BenzeneBots/Swerve_Drive/README.md

# Swerve_Drive
Swerve Drive Design

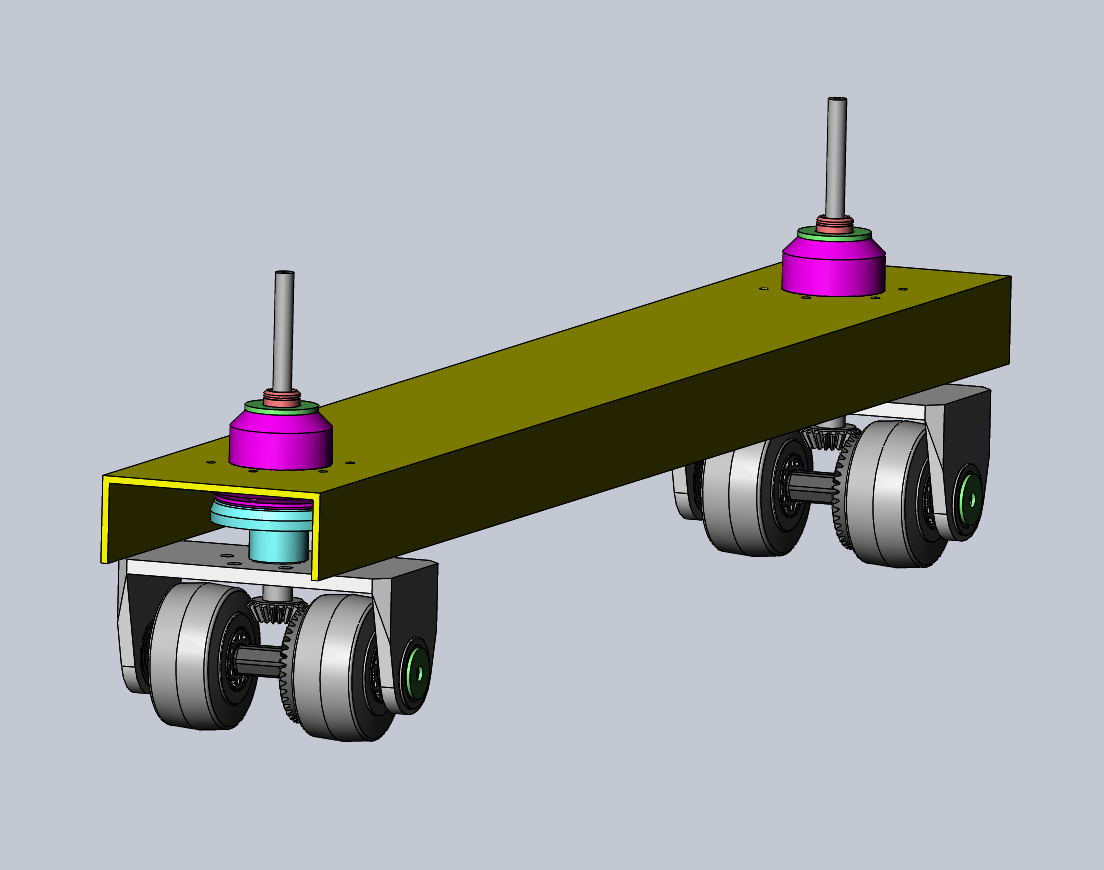
[picture p1: Docs/BB_Swerve_Frame.png]
