BenzeneBots/Swerve_Drive/FRC_2767/thirdcoast-master/README.md

Stryke Force team 2767's Third Coast swerve drive, talon configuration and telemetry API for FRC robots.



Information on these topics are available on the [Third Coast web page][site].

- Third Coast [Javadocs][javadoc].

- Third Coast [Swerve Drive][swerve].

- [Talon Configuration API][talon].

- [Telemetry API][telemetry] data streaming service for robot sensors, actuators or subsystems.

[site]: https://strykeforce.github.io/tags/thirdcoast/
[javadoc]: https://strykeforce.github.io/thirdcoast/javadoc/
[swerve]: https://strykeforce.github.io/tags/swerve/
[talon]: https://strykeforce.github.io/tags/talon/
[telemetry]: https://strykeforce.github.io/tags/telemetry/
