BenzeneBots/Swerve_Drive/FRC_2767/frc-2767-styke-force-2017-1.snapshot.6/2017 hang.jpg

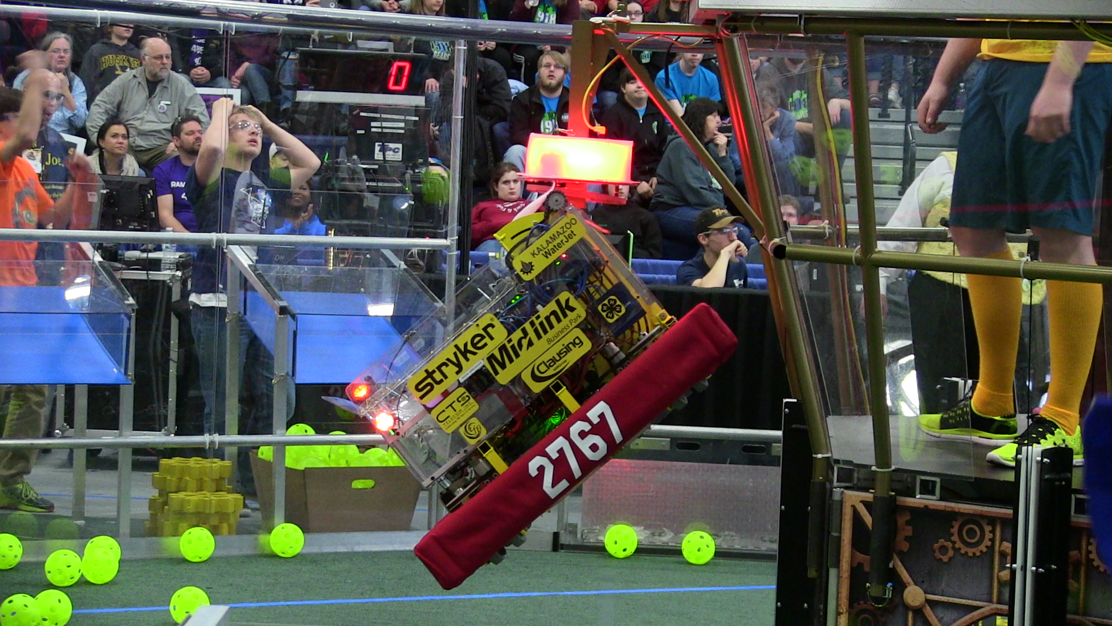
FRC_2767/frc-2767-styke-force-2017-1.snapshot.6/2017 hang.jpg
