BenzeneBots/Swerve_Drive/Docs/Swerve BOM.ods

BB - 3rd Coast Swerve Drive
BOM / Bill of Material |  |  |  |  |  | Total Price (one wheel set): | $502.56
 |  |  |  |  |  | Total Price (eight wheel sets): | $3,974.70
Item Num | Description | Notes | Part Num | Vendor | Qty | Price | Total Price
1 | Saddle – 5” Sq Tube x 0.25 Wall x 12” Length | 12” makes 8 Saddle Pcs |  | Alro | 0.125 | $45.80 | $5.73
2 | Bevel Gear: 40T 1.25 Mod 0.375 in. Hex, Steel | Main Drive Gear | am-2620 | AndyMark | 1 | $42.00 | $42.00
3 | Bevel Gear: 20T 1.25 Mod 8mm, 2mm Key, Steel | Drives Main Gear | am-2621 | AndyMark | 1 | $29.00 | $29.00
4 | Colson Wheel (2.5" x 1.25", 1/2" Hex bore) | 2 1/2” Wheel |  | wcproducts.net | 2 | $5.99 | $11.98
5 | 8mm Diameter, 150mm Long, Steel Drive Shaft | Case Hardened | S40LPSM03080150 | http://www.sdp-si.com/ | 1 | $19.80 | $19.80
6 | 2024 Aluminum Tube 5/8” OD x 0.083 Wall x 32” | Need 3” in length. | 1968T82 | McMaster | 0.1 | $32.08 | $3.21
7 | Needle Bearing for 8mm Shaft | Upper Shaft Support | 5905K73 | McMaster | 1 | $4.59 | $4.59
8 | Ball Bearing, 8 mm x 19 mm x 6 mm Flanged | Bottom Shaft Support | am-0931 | AndyMark | 1 | $4.50 | $4.50
9 | 775Pro Motor, Vex Gearbox, Encoder | 775 Pro |  | VEX | 1 | $170.00 | $170.00
10 | Aluminum 3” Bar Stock – Sold by the Inch | Drive Hubs |  | Alro | 5 | $3.62 | $18.10
11 | Bag Motor & 100:1 Gearbox with Encoder | Steering Motor | VERSAPLANETARY-N-217-5994-217-5046-217-3351-217-2816-217-4973-217-2820 | Vex | 1 | $174.92 | $174.92
12 | HTD Timing Belt / 70 Teeth / 5mm x 9mm |  | https://shop.sdp-si.com/catalog/product/?id=A_6R25M070090 | Sdp-si | 1 | $8.78 | $8.78
13 | HTD Timing Belt / 96 Teeth / 5mm x 9mm |  |  | Sdp-si | 1 | $9.96 | $9.96
