BenzeneBots/Swerve_Drive/Swerve_Drive_CAD/Drive_Assem.SLDASM

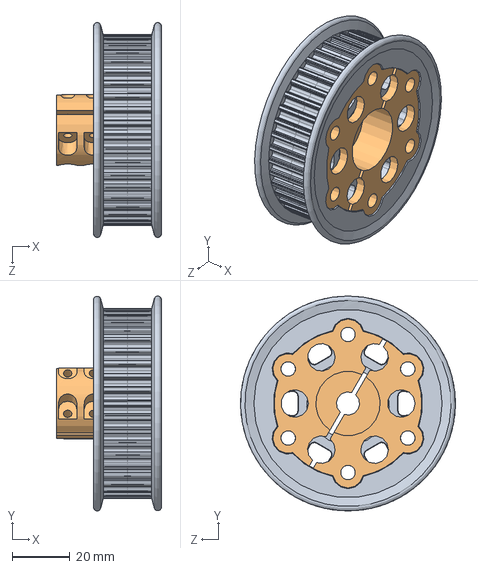
[picture p53: CAD file, 2018-11-18]
Swerve_Drive_CAD/Drive_Assem.SLDASM
36.1 x 74.1 x 74.1 mm
am-2234_42toothHTDpulleyHalfRev2 x 2
Pulley_Driver
