BenzeneBots/Swerve_Drive/Swerve_Drive_CAD/BB_Swerve_Assem.SLDASM

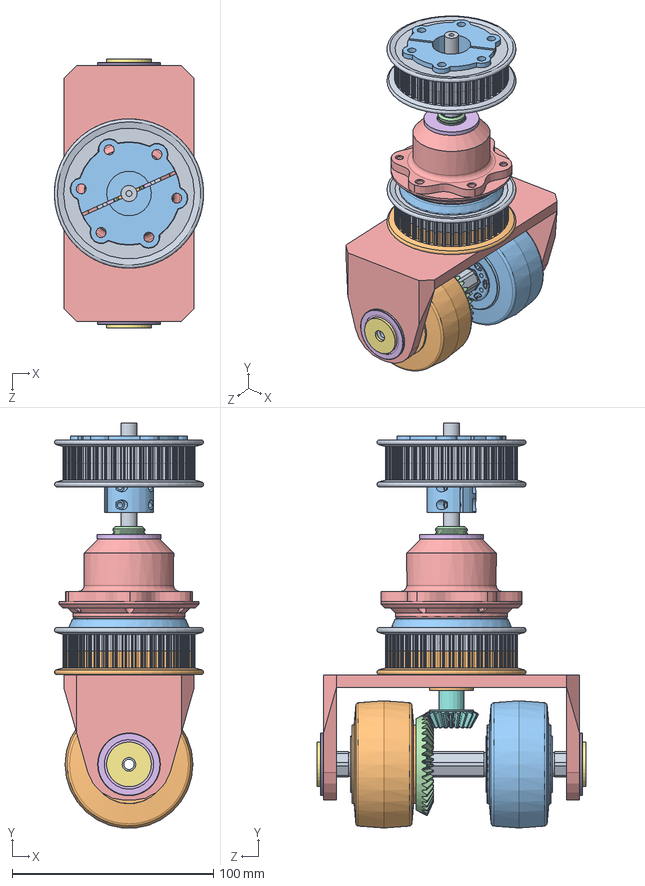
[picture p54: CAD file, 2018-11-18]
Swerve_Drive_CAD/BB_Swerve_Assem.SLDASM
74.1 x 201.0 x 133.7 mm
_2016_SWERVE_AXLE_RNM_RNM
_COLSON_WHEEL_MODIFIED
_217-4046-STEP-20141030
_AM-2620_40T_1-25MOD_BEVEL_GEAR
BB_Swerve_Saddle
_217-4006-STEP-20140807 x 2
_91525A119 x 2
_AM-2621_20T_1-25MOD_BEVEL_GEAR
_8MM_VERT_DRIVE_SHAFT
_AM_0931
_SWERVE_PIVOT_HUB_MOUNT
_SWERVE_PIVOT_HUB_TUBE
_SWERVE_MOUNTING_HUB
_AL_WASHER
_STEEL_SHIM_WASHER x 2
_9657K101_STEEL_COMPRESSION_SPRI
am-2234_42toothHTDpulleyHalfRev2 x 3
am-2234_42t_trimmed
Pulley_Driver
