BenzeneBots/Swerve_Drive/Swerve_Drive_CAD/VersaPlanetary_Integrated_Encoder_217-50461.SLDASM

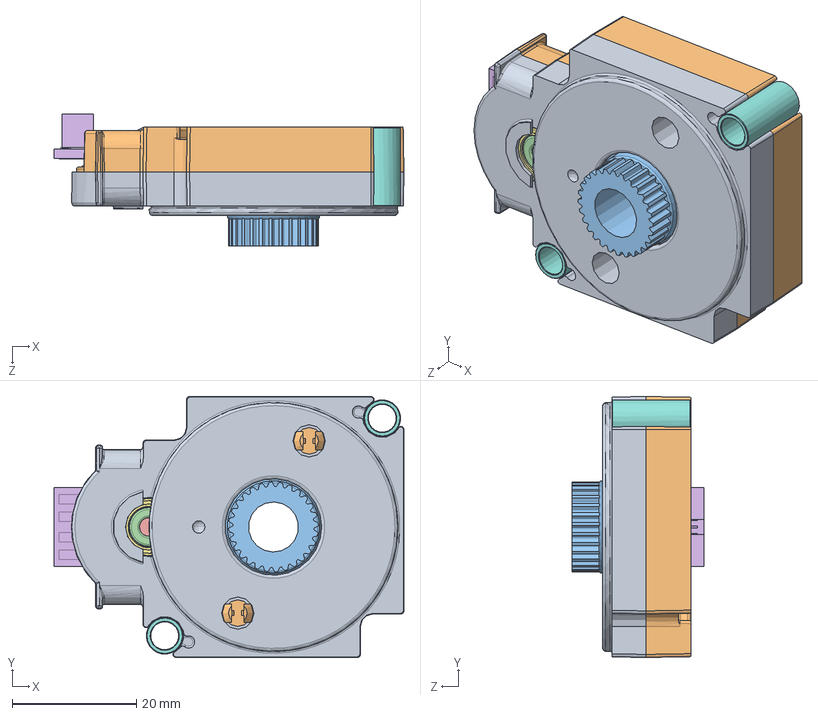
[picture p55: CAD file, 2018-11-13]
Swerve_Drive_CAD/VersaPlanetary_Integrated_Encoder_217-50461.SLDASM
56.3 x 42.0 x 21.2 mm
217-4783-001 Rev3_1
217-4783-002 Rev7_Sealed Config_1
217-4783-005 Rev7_40t_spur_REF_14deg_1
217-4783-004 Rev2_40t_spur_REF_14deg_1
217-4783-008 Rev2_1
PCBA Rev3_1
217-2788-001 Rev3_57155K375_1
217-4783-006 Rev3_1 x 2
217-4783-007 Rev1_1
217-4783-003 Rev4_1
