BenzeneBots/Swerve_Drive/Swerve_Drive_CAD/VersaPlanetary_v1_Two_Stage_100_1_with_BAG.SLDASM

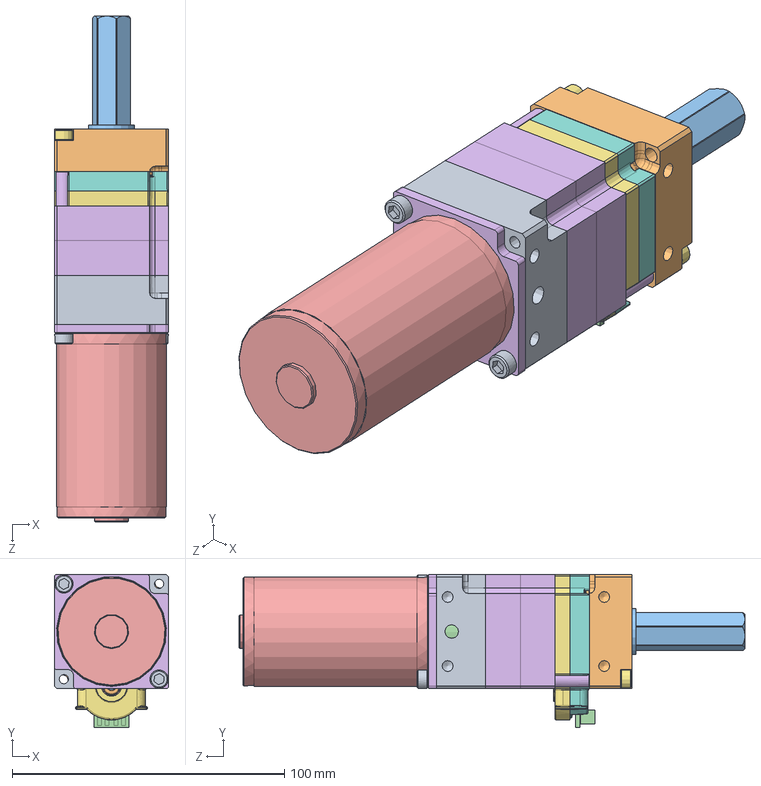
[picture p56: CAD file, 2018-11-13]
Swerve_Drive_CAD/VersaPlanetary_v1_Two_Stage_100_1_with_BAG.SLDASM
42.0 x 56.3 x 186.0 mm
217-2625-001 Rev1
217-2625-002 Rev1
217-2625-003 Rev1_1
217-2625-009 Rev1
217-2625-008 Rev1_1
217-2625-010 Rev1_1 x 7
217-2625-005 Rev1_Planet_Revolving_Follower01_1 x 3
217-2625-007 Rev1_Sun_Driver01
SSS1032-0125ZB_94105A824
TRUARC-5103-68_97414A675_grv
217-2816-001 Rev1_1 x 2
SSA_SSA0832-1750ZC x 2
217-2625-011 Rev1_1
SSA_SSA0832-0500ZC x 2
SSHCM004_SSHCM004070010C x 2
217-2725-001 Rev1_24t Sun
217-2725-002 Rev1_24t Planet x 4
217-2724-002 Rev1
217-2822-003 Rev4_1
217-4783-001 Rev3
217-4783-002 Rev7_Sealed Config
217-4783-005 Rev7_40t_spur_REF_14deg
217-4783-004 Rev2_40t_spur_REF_14deg
217-4783-008 Rev2
PCBA Rev3
217-2788-001 Rev3_57155K375
217-4783-006 Rev3 x 2
217-4783-007 Rev1
217-4783-003 Rev4
