BenzeneBots/Swerve_Drive/FRC_2767/FRC 2767 2018 CAD/2018_swerve_module_asm.SLDASM

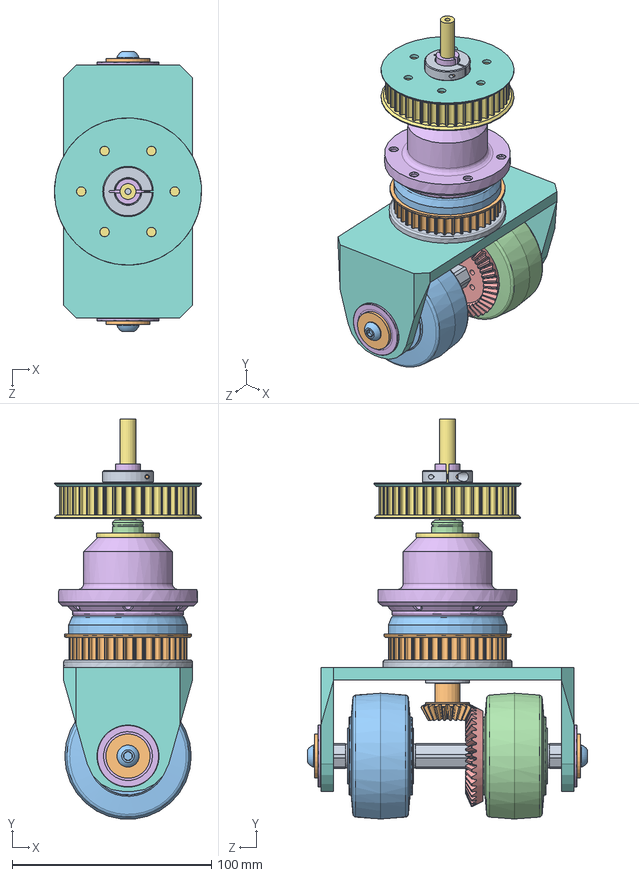
[picture p57: CAD file, 2018-10-16]
FRC_2767/FRC 2767 2018 CAD/2018_swerve_module_asm.SLDASM
73.9 x 200.8 x 140.4 mm
2016_SWERVE_AXLE_RNM_RNM
AM-2621_20T_1-25MOD_BEVEL_GEAR
217-4046-STEP-20141030
COLSON_WHEEL_MODIFIED
AM-2620_40T_1-25MOD_BEVEL_GEAR
217-4006-STEP-20140807 x 2
8MM_VERT_DRIVE_SHAFT
SWERVE_SADDLE
38T_HTD_PULLEY_AZ_FLANGE
HTD_TB_PULLEY_38T_SWERVE
SWERVE_PIVOT_HUB_MOUNT
SWERVE_PIVOT_HUB_TUBE
TOPHAT_SLEEVE
AL_WASHER
5905K730_STL_NEEDLE-ROLLER_BRNG
AM_0931
91525A119 x 2
98164A211 x 2
STEEL_SHIM_WASHER x 2
9657K101_STEEL_COMPRESSION_SPRI
