BenzeneBots/Swerve_Drive/Swerve_Drive_CAD/AM-2234_Assem.SLDASM

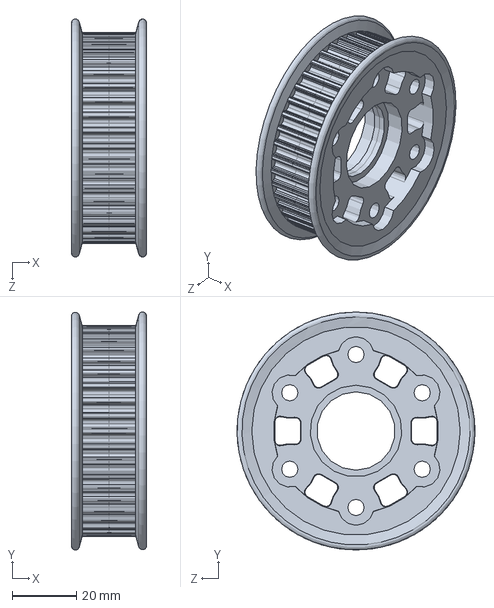
[picture p58: CAD file, 2018-11-10]
Swerve_Drive_CAD/AM-2234_Assem.SLDASM
23.4 x 74.1 x 74.1 mm
am-2234_42t_trimmed x 2
