BenzeneBots/Swerve_Drive/Swerve_Drive_CAD/775Pro_Gearbox_Assem.SLDASM

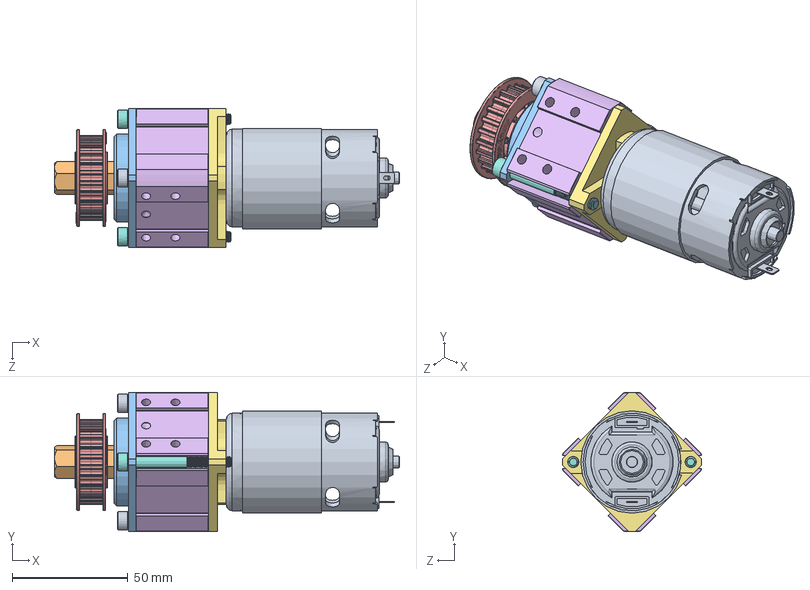
[picture p59: CAD file, 2018-11-10]
Swerve_Drive_CAD/775Pro_Gearbox_Assem.SLDASM
149.2 x 60.3 x 60.3 mm
am-3775+RedLine+Motor
am-XXXX - 57 Sport 500 Hex Shaft
Output Block
FR8ZZ Bearing x 2
retaining Ring 0500 - Mcm 98410A122_98410A122
am-XXXX - 57 Sport 1 Stage Ring Gear Housing
am-3765 - 57 Sport Motor Block
10-32 x 1.750 SHCS_90128A953 x 2
10-32 X 375 SHCS_90128A940 x 2
am-XXXX - 57 Sport Shaft Carrier Plate
16T Planet Gear x 4
Thrust washer - 775 Sport
am-3403+24+tooth+HTD+pulley+half+500hex x 2
