BenzeneBots/Swerve_Drive/Swerve_Drive_CAD/BB_Pivot_Hub_Assem.SLDASM

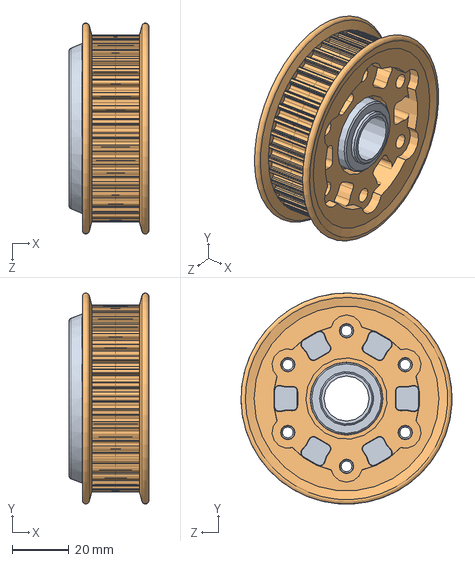
[picture p60: CAD file, 2018-11-10]
Swerve_Drive_CAD/BB_Pivot_Hub_Assem.SLDASM
28.0 x 74.1 x 74.1 mm
_SWERVE_PIVOT_HUB_MOUNT
am-2234_42toothHTDpulleyHalfRev2 x 2
