BenzeneBots/Swerve_Drive/Swerve_Drive_CAD/VersaPlanetary_v2_Single_Stage_10_1_with_BAG.SLDASM

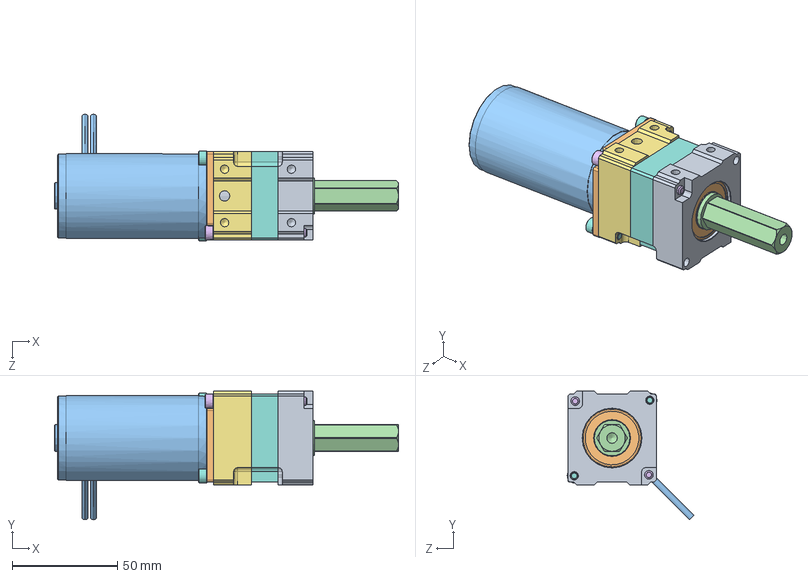
[picture p61: CAD file, 2018-11-10]
Swerve_Drive_CAD/VersaPlanetary_v2_Single_Stage_10_1_with_BAG.SLDASM
163.4 x 61.0 x 60.1 mm
217-2625-026 Rev1
217-2742-001 Rev4 x 2
217-2625-017 Rev1_9714K61
217-2625-003 Rev1
217-2625-018 Rev1_98541A410
832-1750-Ring-Gear-Screw_SSA0832-0500ZC x 2
217-2625-025 Rev1
217-4649-002 Rev1_SSA0832-0500ZC x 2
217-4649-006 Rev1_SSA0004-008BA x 2
217-2822-003 Rev4
217-3351 Rev2
217-2625-008 Rev1
217-2625-010 Rev1 x 3
217-2625-005 Rev1_Planet_Revolving_Follower01 x 3
217-2625-007 Rev1_Public
217-2816-001 Rev1
217-4649-001 Rev1
217-4649-007 Rev1_94105A824
217-2625-011 Rev1
