BenzeneBots/Swerve_Drive/Swerve_Drive_CAD/BB_Serve_Frame_Assem.SLDASM

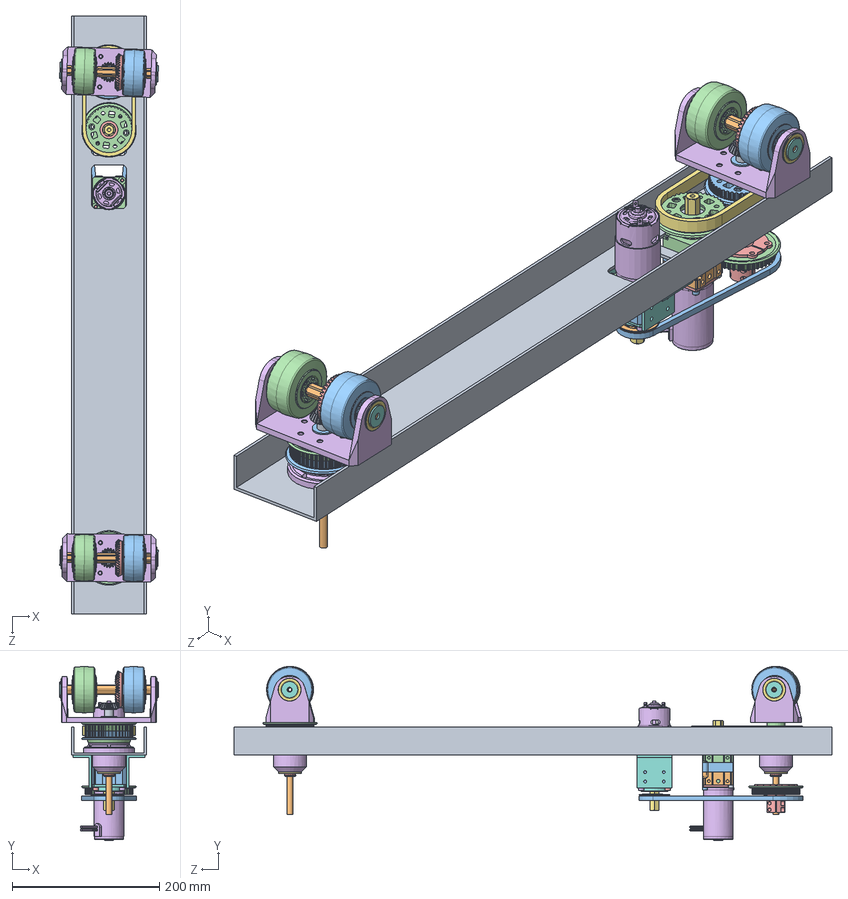
[picture p62: CAD file, 2018-11-10]
Swerve_Drive_CAD/BB_Serve_Frame_Assem.SLDASM
134.4 x 236.6 x 812.8 mm
Frame
_2016_SWERVE_AXLE_RNM_RNM x 2
_COLSON_WHEEL_MODIFIED x 2
_217-4046-STEP-20141030 x 2
_AM-2620_40T_1-25MOD_BEVEL_GEAR x 2
BB_Swerve_Saddle x 2
_217-4006-STEP-20140807 x 4
_91525A119 x 4
_AM-2621_20T_1-25MOD_BEVEL_GEAR x 2
_8MM_VERT_DRIVE_SHAFT x 2
_AM_0931 x 2
_SWERVE_PIVOT_HUB_MOUNT x 2
_SWERVE_PIVOT_HUB_TUBE x 2
_SWERVE_MOUNTING_HUB x 2
_AL_WASHER x 2
_TOPHAT_SLEEVE x 2
_STEEL_SHIM_WASHER x 4
_9657K101_STEEL_COMPRESSION_SPRI x 2
am-2234_42toothHTDpulleyHalfRev2 x 2
am-2234_42t_trimmed x 3
Pulley_Driver
am-3775+RedLine+Motor
am-XXXX - 57 Sport 500 Hex Shaft
Output Block
FR8ZZ Bearing x 2
retaining Ring 0500 - Mcm 98410A122_98410A122
am-XXXX - 57 Sport 1 Stage Ring Gear Housing
am-3765 - 57 Sport Motor Block
10-32 x 1.750 SHCS_90128A953 x 2
10-32 X 375 SHCS_90128A940 x 2
am-XXXX - 57 Sport Shaft Carrier Plate
16T Planet Gear x 4
Thrust washer - 775 Sport
am-3403+24+tooth+HTD+pulley+half+500hex
Drive_Belt
217-2625-026 Rev1
217-2742-001 Rev4 x 2
217-2625-017 Rev1_9714K61
217-2625-003 Rev1
217-2625-018 Rev1_98541A410
832-1750-Ring-Gear-Screw_SSA0832-0500ZC x 2
217-2625-025 Rev1
217-4649-002 Rev1_SSA0832-0500ZC x 2
217-4649-006 Rev1_SSA0004-008BA x 2
217-2822-003 Rev4
217-3351 Rev2
217-2625-008 Rev1
217-2625-010 Rev1 x 3
217-2625-005 Rev1_Planet_Revolving_Follower01 x 3
217-2625-007 Rev1_Public
217-2816-001 Rev1
217-4649-001 Rev1
217-4649-007 Rev1_94105A824
217-2625-011 Rev1
Steer_Belt
Drive_Motor_Mount x 2
