BenzeneBots/Swerve_Drive/Swerve_Drive_CAD/BB_Swerve_Saddle_Assem.SLDASM

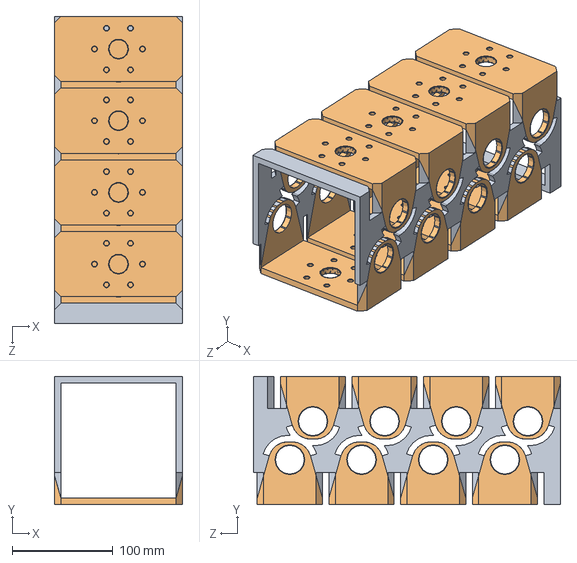
[picture p63: CAD file, 2018-10-16]
Swerve_Drive_CAD/BB_Swerve_Saddle_Assem.SLDASM
127.0 x 127.0 x 304.8 mm
BB_Swerve_Saddle_Stock
BB_Swerve_Saddle x 8
