BenzeneBots/Swerve_Drive/Swerve_Drive_CAD/_8MM_SHAFT_44T_HTD_PULLEY_ASM.sldasm

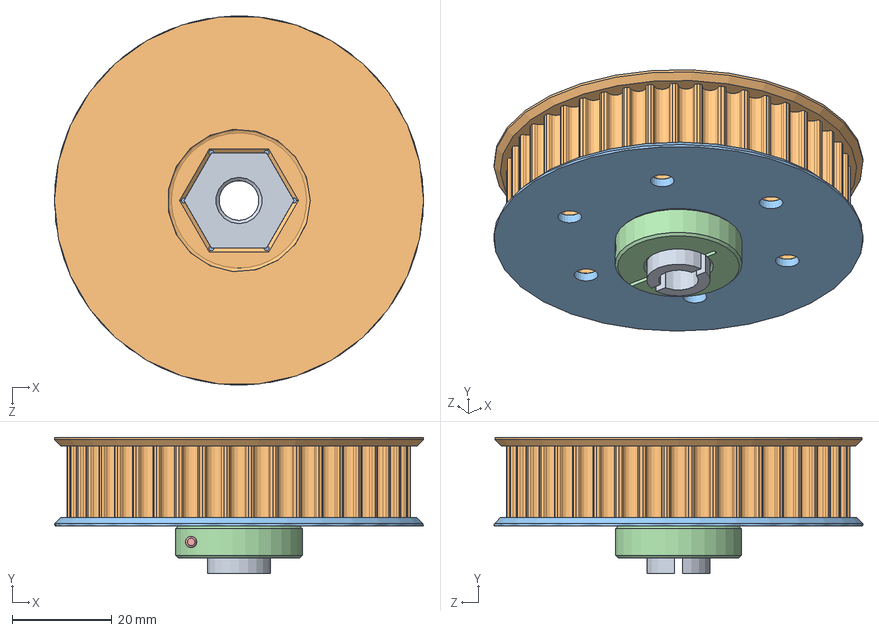
[picture p64: CAD file, 2018-10-12]
Swerve_Drive_CAD/_8MM_SHAFT_44T_HTD_PULLEY_ASM.sldasm
73.9 x 27.3 x 73.9 mm
8MM_PULLEY_HUB
HTD_TB_PULLEY_44T
44T_HTD_PULLEY_FLANGE
217-2736-001_REV1-1-SOLID1
92185A108-1-SOLID1
