BenzeneBots/Swerve_Drive/Swerve_Drive_CAD/Pulley_Driver.SLDPRT

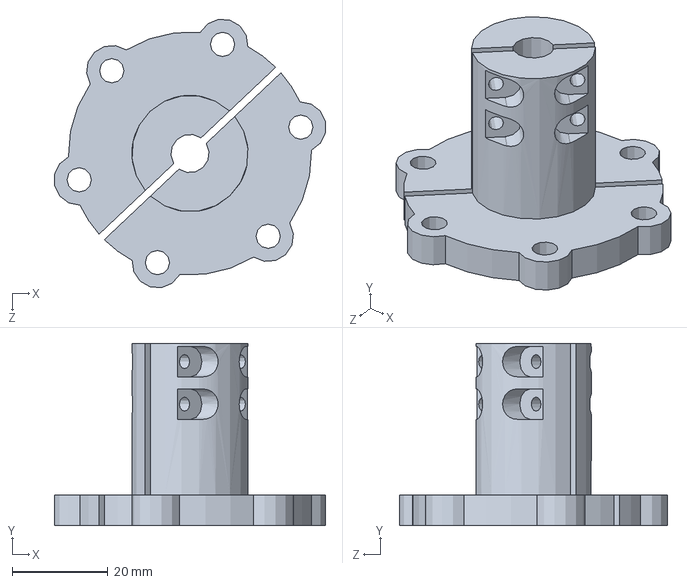
[picture p65: CAD file, 2018-11-18]
Swerve_Drive_CAD/Pulley_Driver.SLDPRT
56.7 x 38.1 x 56.1 mm
