BenzeneBots/Swerve_Drive/Tooling_CAD/Tool_Holder.SLDPRT

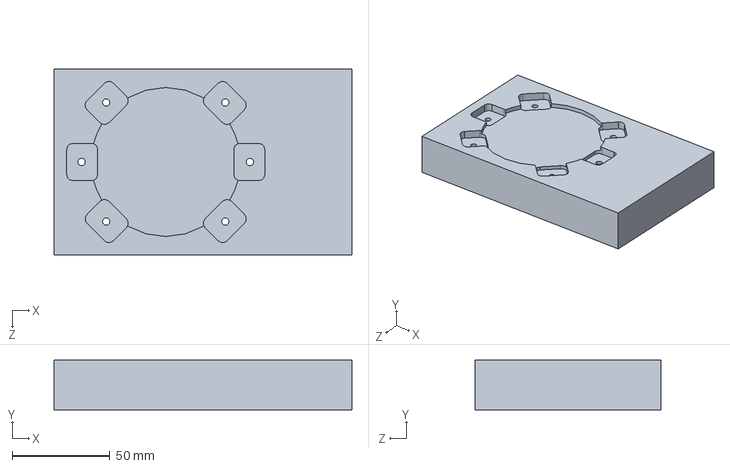
[picture p66: CAD file, 2018-11-10]
Tooling_CAD/Tool_Holder.SLDPRT
152.4 x 25.4 x 95.2 mm
