BenzeneBots/Swerve_Drive/Swerve_Drive_CAD/Steer_Belt.SLDPRT

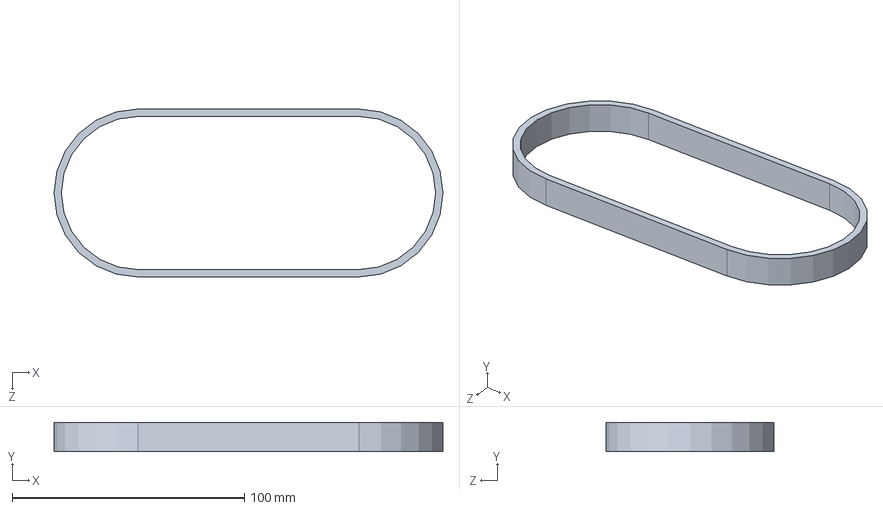
[picture p67: CAD file, 2018-11-13]
Swerve_Drive_CAD/Steer_Belt.SLDPRT
167.6 x 12.7 x 72.3 mm
