BenzeneBots/Swerve_Drive/Swerve_Drive_CAD/_8MM_VERT_DRIVE_SHAFT.SLDPRT

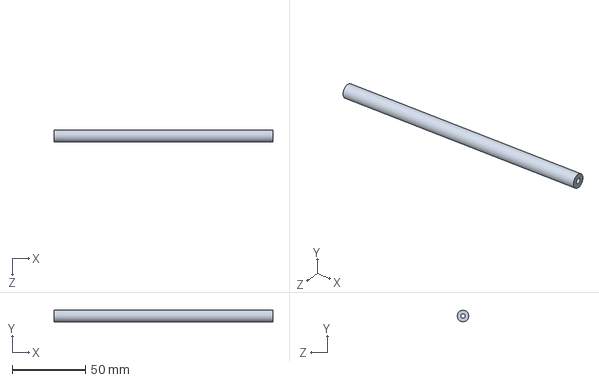
[picture p68: CAD file, 2018-11-13]
Swerve_Drive_CAD/_8MM_VERT_DRIVE_SHAFT.SLDPRT
149.9 x 8.00 x 8.00 mm
