BenzeneBots/Swerve_Drive/FRC_2767/FRC 2767 2018 CAD/SWERVE_SADDLE.sldprt

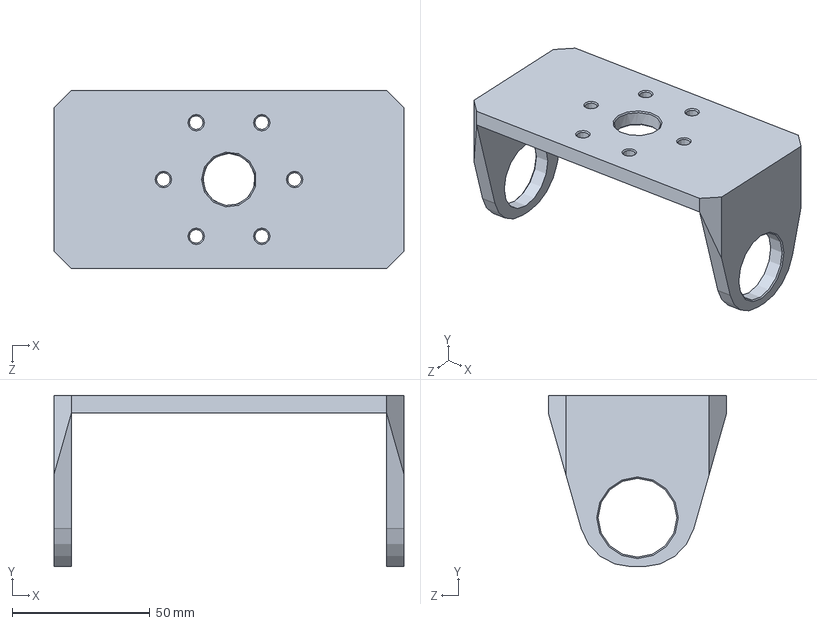
[picture p69: CAD file, 2018-10-16]
FRC_2767/FRC 2767 2018 CAD/SWERVE_SADDLE.sldprt
127.0 x 62.2 x 64.8 mm
