BenzeneBots/Swerve_Drive/Swerve_Drive_CAD/_SWERVE_MOUNTING_HUB.SLDPRT

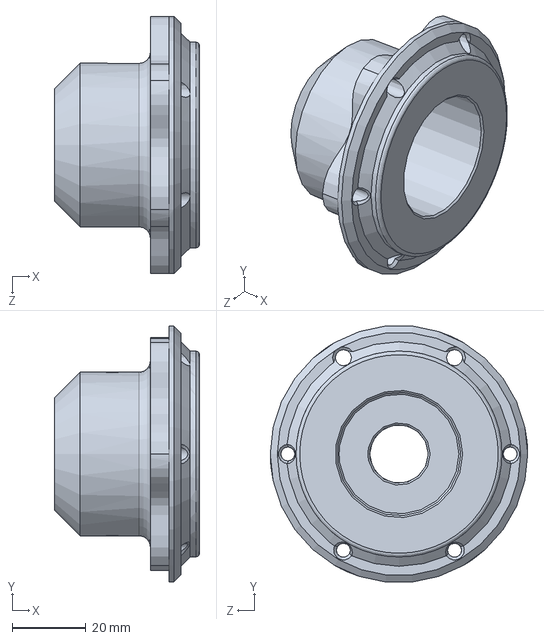
[picture p70: CAD file, 2018-11-13]
Swerve_Drive_CAD/_SWERVE_MOUNTING_HUB.SLDPRT
39.4 x 69.5 x 69.8 mm
