BenzeneBots/Swerve_Drive/FRC_2767/FRC 2767 2018 CAD/AM_0931.sldprt

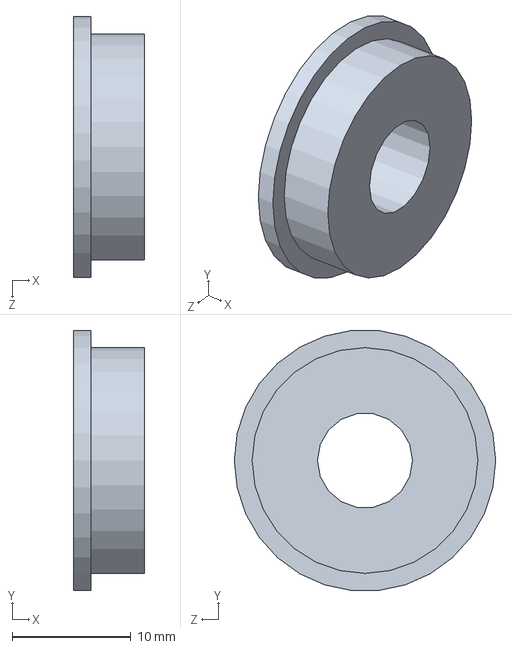
[picture p71: CAD file, 2018-10-16]
FRC_2767/FRC 2767 2018 CAD/AM_0931.sldprt
6.00 x 21.9 x 22.0 mm
