BenzeneBots/Swerve_Drive/Swerve_Drive_CAD/Frame.SLDPRT

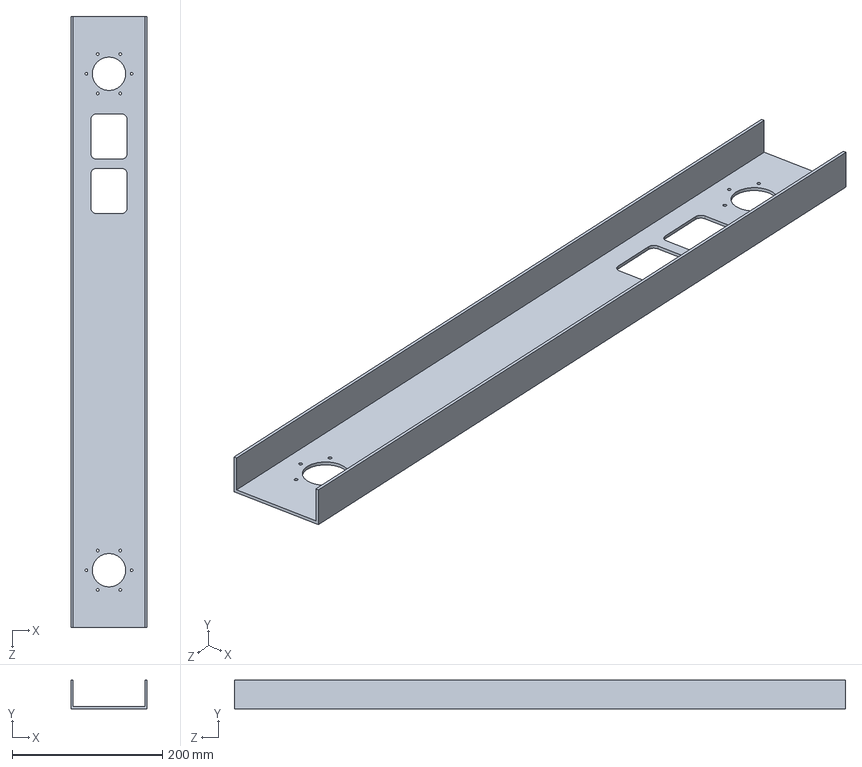
[picture p72: CAD file, 2018-11-13]
Swerve_Drive_CAD/Frame.SLDPRT
101.6 x 38.1 x 812.8 mm
