BenzeneBots/Swerve_Drive/Swerve_Drive_CAD/_SWERVE_PIVOT_HUB_MOUNT.SLDPRT

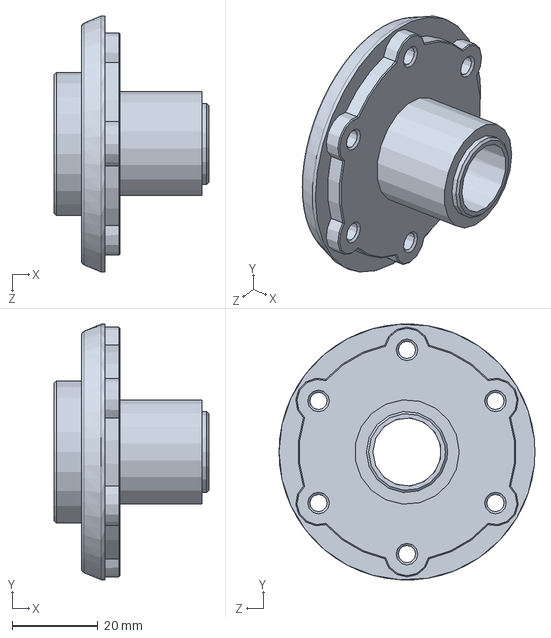
[picture p73: CAD file, 2018-11-13]
Swerve_Drive_CAD/_SWERVE_PIVOT_HUB_MOUNT.SLDPRT
36.1 x 59.6 x 59.7 mm
