BenzeneBots/Swerve_Drive/Swerve_Drive_CAD/_9657K101_STEEL_COMPRESSION_SPRI.sldprt

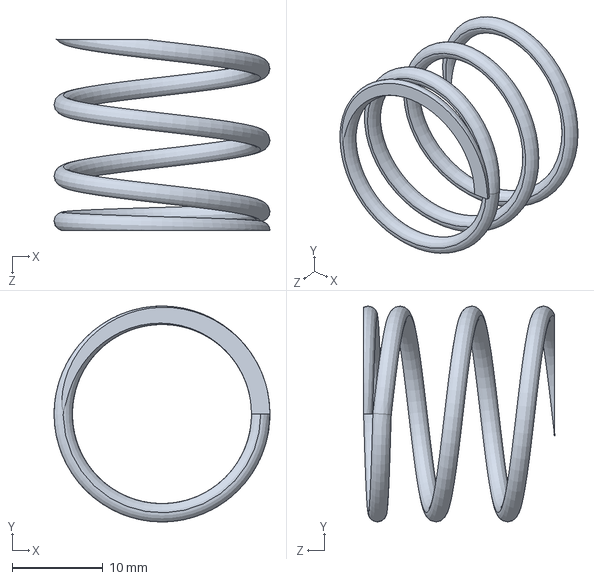
[picture p74: CAD file, 2018-11-10]
Swerve_Drive_CAD/_9657K101_STEEL_COMPRESSION_SPRI.sldprt
23.8 x 23.8 x 21.1 mm
