BenzeneBots/Swerve_Drive/Swerve_Drive_CAD/Drive_Motor_Mount.SLDPRT

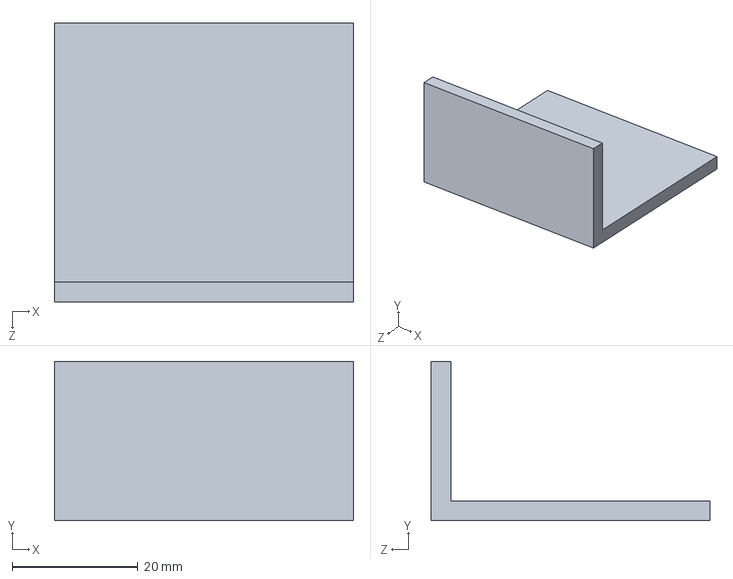
[picture p76: CAD file, 2018-11-10]
Swerve_Drive_CAD/Drive_Motor_Mount.SLDPRT
47.6 x 25.4 x 44.5 mm
