BenzeneBots/Swerve_Drive/Swerve_Drive_CAD/am-3775+RedLine+Motor.STEP

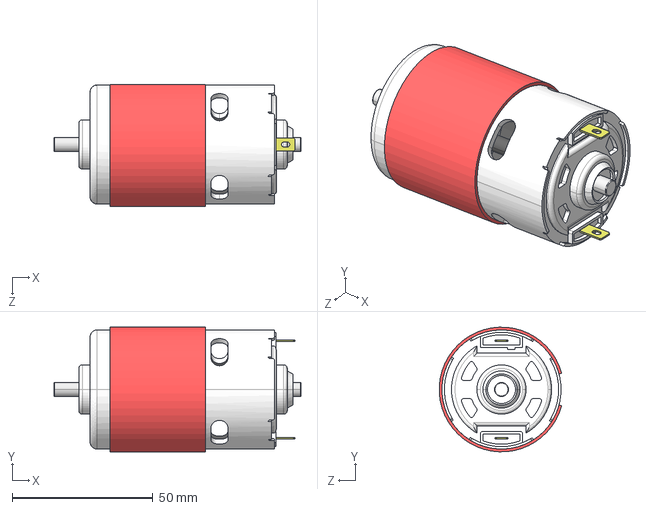
[picture p77: CAD file, 2018-11-10]
Swerve_Drive_CAD/am-3775+RedLine+Motor.STEP
87.7 x 44.3 x 43.5 mm
