BenzeneBots/Swerve_Drive/Swerve_Drive_CAD/am-2234_42t_trimmed.SLDPRT

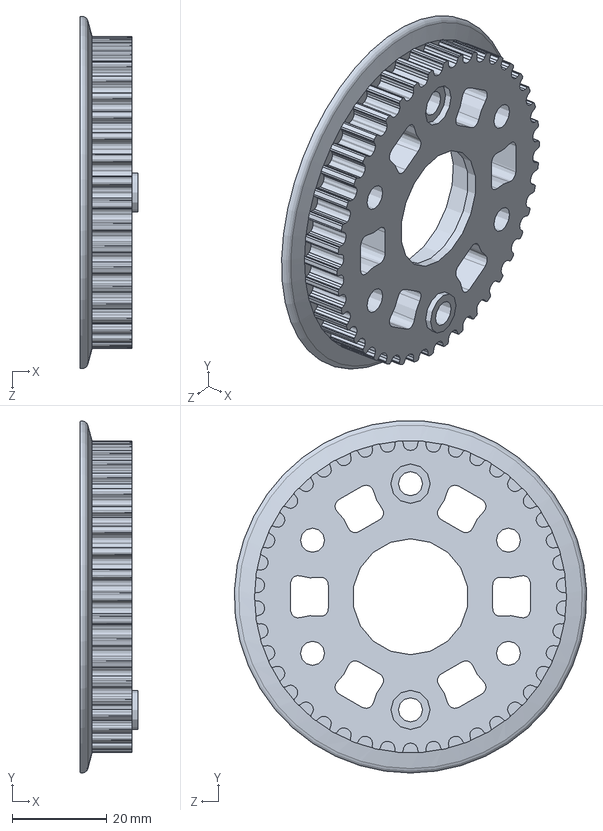
[picture p78: CAD file, 2018-11-10]
Swerve_Drive_CAD/am-2234_42t_trimmed.SLDPRT
12.1 x 74.1 x 74.2 mm
