BenzeneBots/Swerve_Drive/Swerve_Drive_CAD/am-2234_42toothHTDpulleyHalfRev2.STEP

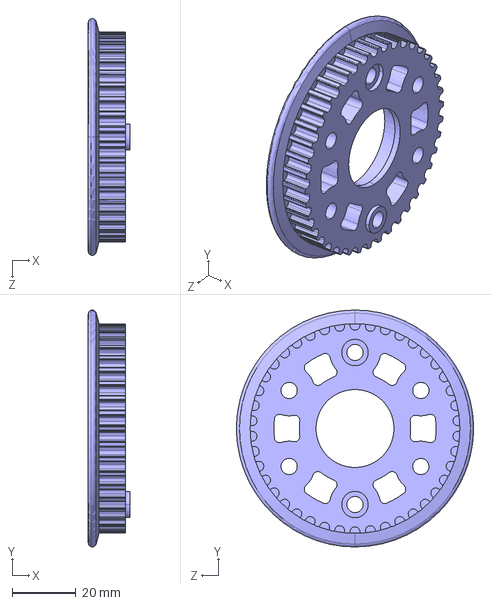
[picture p79: CAD file, 2018-11-10]
Swerve_Drive_CAD/am-2234_42toothHTDpulleyHalfRev2.STEP
13.0 x 74.2 x 74.2 mm
