BenzeneBots/Swerve_Drive/Swerve_Drive_CAD/_SWERVE_PIVOT_HUB_TUBE.SLDPRT

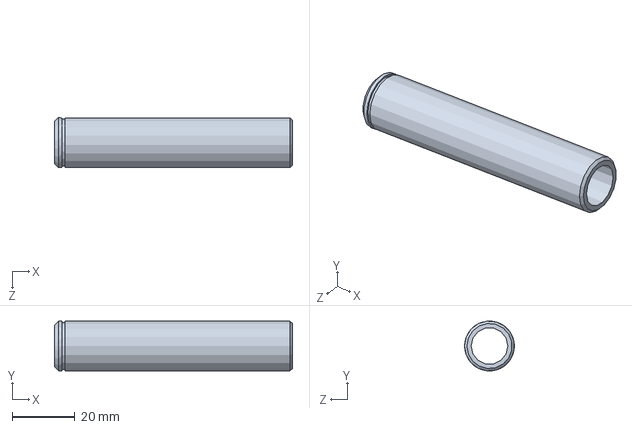
[picture p80: CAD file, 2018-11-10]
Swerve_Drive_CAD/_SWERVE_PIVOT_HUB_TUBE.SLDPRT
75.6 x 15.8 x 15.9 mm
