BenzeneBots/Swerve_Drive/Swerve_Drive_CAD/_TOPHAT_SLEEVE.SLDPRT

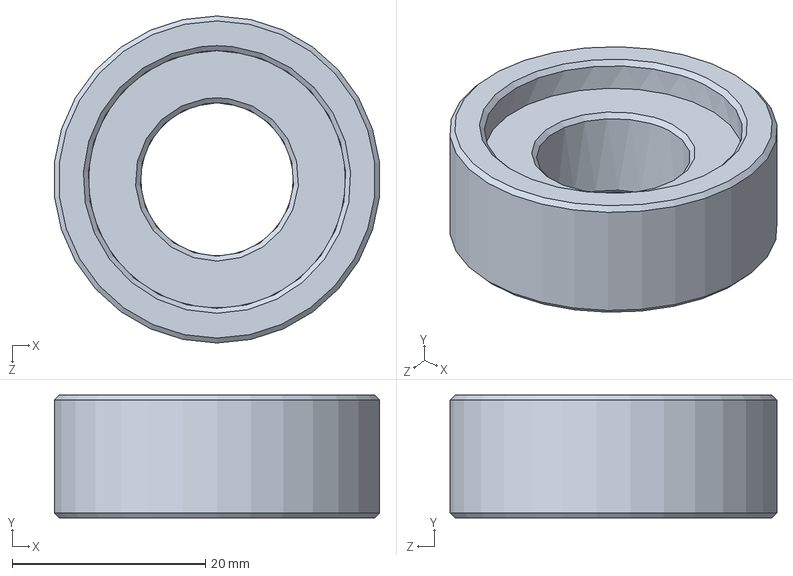
[picture p81: CAD file, 2018-11-10]
Swerve_Drive_CAD/_TOPHAT_SLEEVE.SLDPRT
33.6 x 12.7 x 33.8 mm
