BenzeneBots/Swerve_Drive/Swerve_Drive_CAD/_217-4006-STEP-20140807.SLDPRT

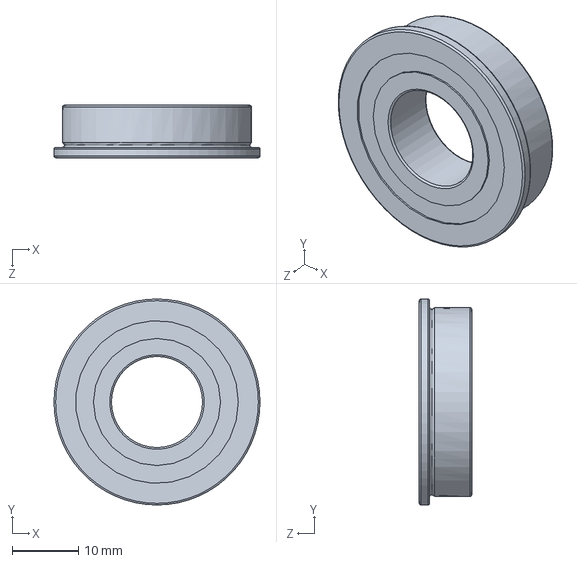
[picture p82: CAD file, 2018-11-10]
Swerve_Drive_CAD/_217-4006-STEP-20140807.SLDPRT
31.1 x 31.1 x 7.94 mm
