BenzeneBots/Swerve_Drive/Swerve_Drive_CAD/_2016_SWERVE_AXLE_RNM_RNM.SLDPRT

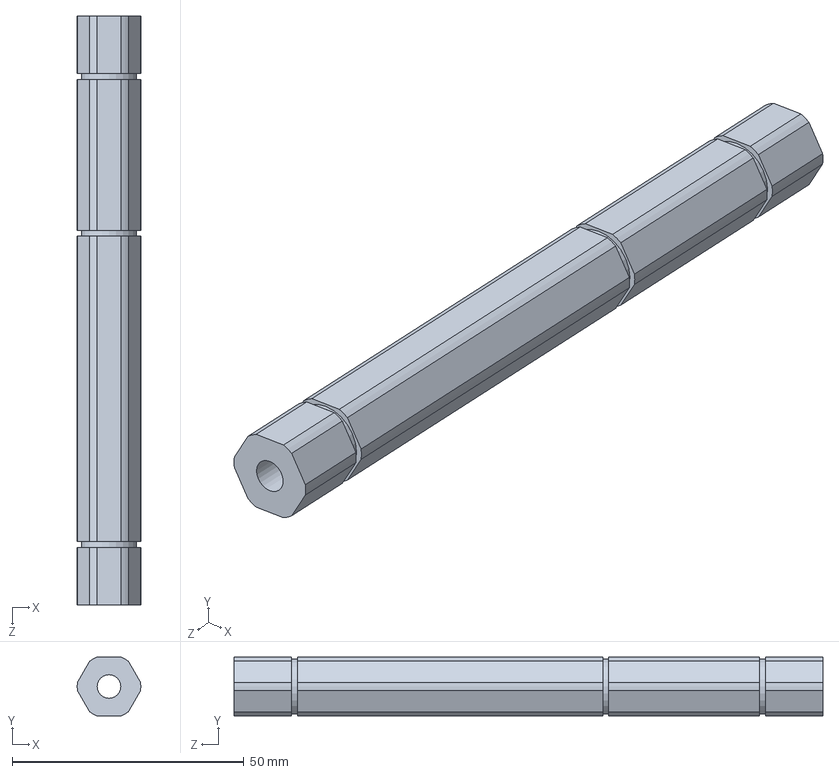
[picture p83: CAD file, 2018-11-10]
Swerve_Drive_CAD/_2016_SWERVE_AXLE_RNM_RNM.SLDPRT
13.7 x 12.7 x 127.0 mm
