BenzeneBots/Swerve_Drive/Swerve_Drive_CAD/_217-4046-STEP-20141030.SLDPRT

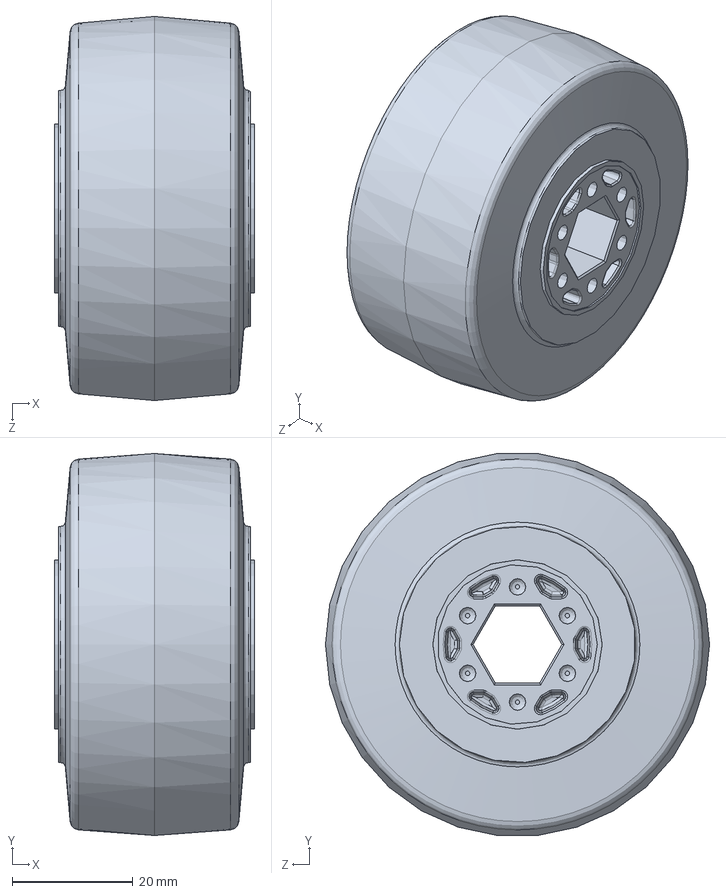
[picture p84: CAD file, 2018-11-10]
Swerve_Drive_CAD/_217-4046-STEP-20141030.SLDPRT
33.1 x 63.2 x 63.5 mm
