BenzeneBots/Swerve_Drive/Swerve_Drive_CAD/Hex_Bore_Machining.SLDPRT

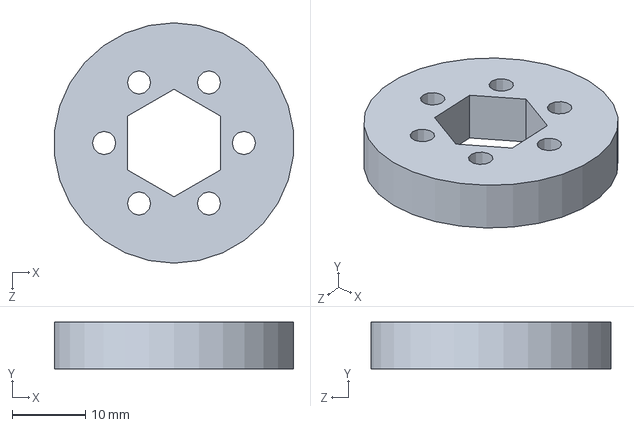
[picture p85: CAD file, 2018-11-10]
Swerve_Drive_CAD/Hex_Bore_Machining.SLDPRT
32.6 x 6.35 x 32.8 mm
