BenzeneBots/Swerve_Drive/Swerve_Drive_CAD/_COLSON_WHEEL_MODIFIED.SLDPRT

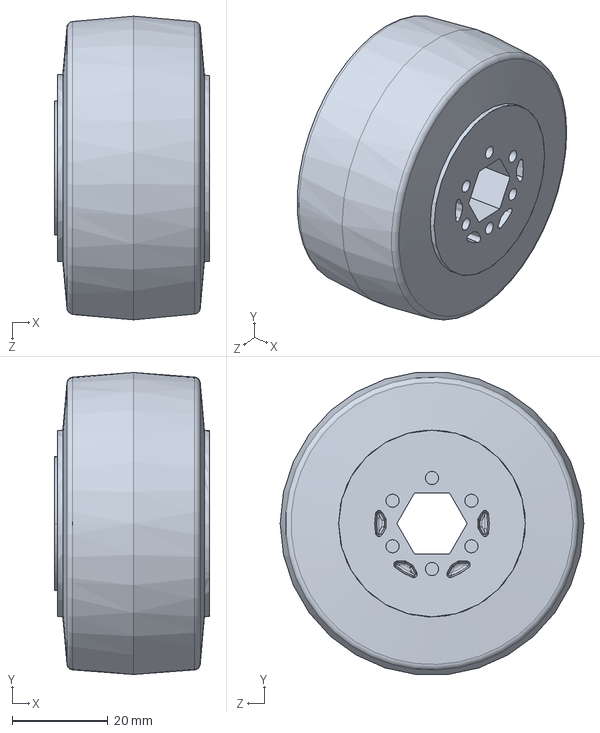
[picture p86: CAD file, 2018-11-10]
Swerve_Drive_CAD/_COLSON_WHEEL_MODIFIED.SLDPRT
32.4 x 63.2 x 63.5 mm
