BenzeneBots/Swerve_Drive/Swerve_Drive_CAD/_91525A119.SLDPRT

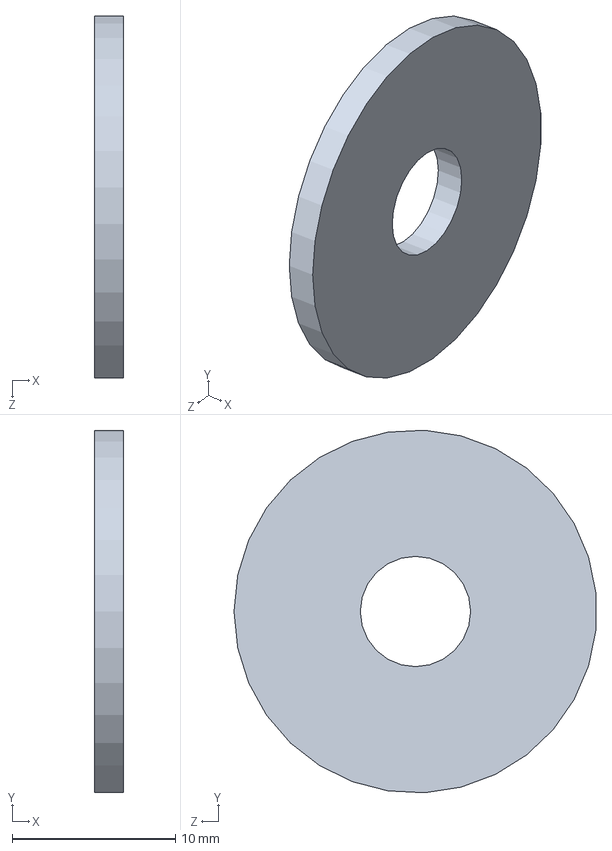
[picture p87: CAD file, 2018-11-10]
Swerve_Drive_CAD/_91525A119.SLDPRT
1.78 x 22.2 x 22.2 mm
