BenzeneBots/Swerve_Drive/Swerve_Drive_CAD/_AM-2621_20T_1-25MOD_BEVEL_GEAR.SLDPRT

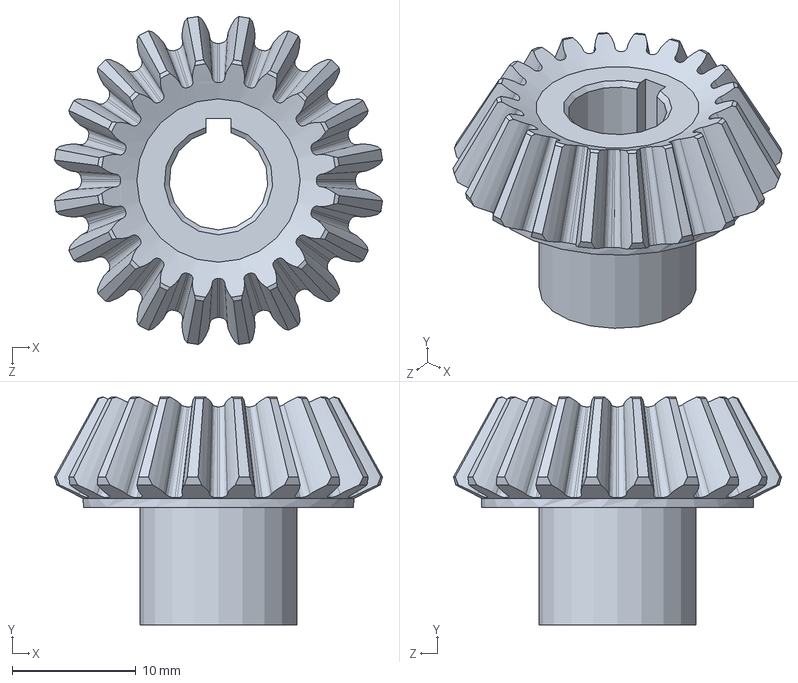
[picture p88: CAD file, 2018-11-10]
Swerve_Drive_CAD/_AM-2621_20T_1-25MOD_BEVEL_GEAR.SLDPRT
26.6 x 18.4 x 26.6 mm
