BenzeneBots/Swerve_Drive/Swerve_Drive_CAD/am-3403+24+tooth+HTD+pulley+half+500hex.STEP

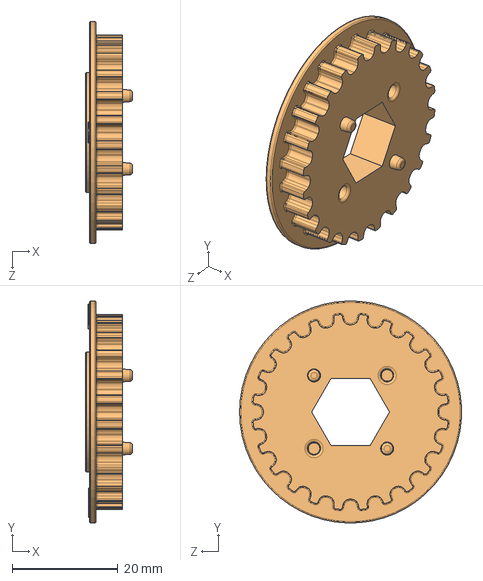
[picture p89: CAD file, 2018-11-10]
Swerve_Drive_CAD/am-3403+24+tooth+HTD+pulley+half+500hex.STEP
8.91 x 42.0 x 42.0 mm
