BenzeneBots/Swerve_Drive/Swerve_Drive_CAD/_AM-2620_40T_1-25MOD_BEVEL_GEAR.SLDPRT

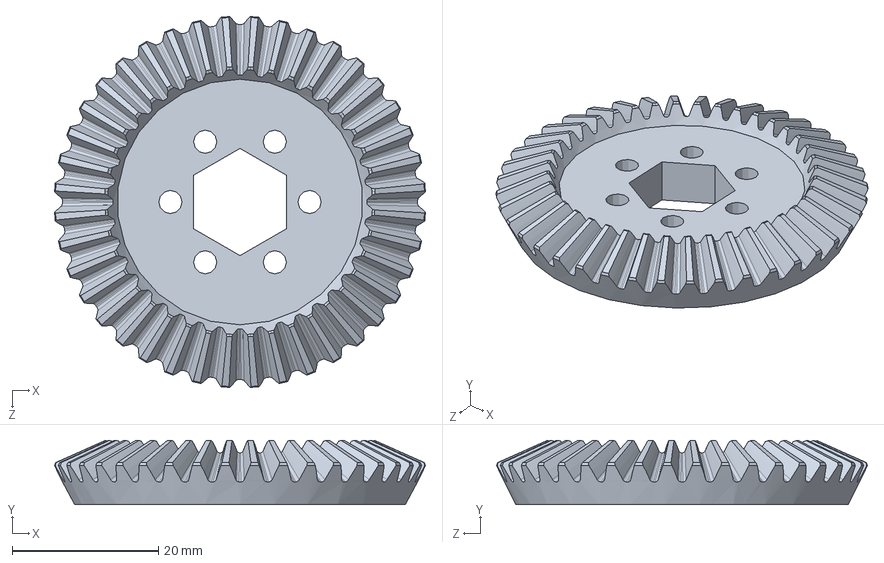
[picture p90: CAD file, 2018-11-10]
Swerve_Drive_CAD/_AM-2620_40T_1-25MOD_BEVEL_GEAR.SLDPRT
50.8 x 8.77 x 50.8 mm
