BenzeneBots/Swerve_Drive/Swerve_Drive_CAD/am-3765+-+57+Sport+Motor+Block.STEP

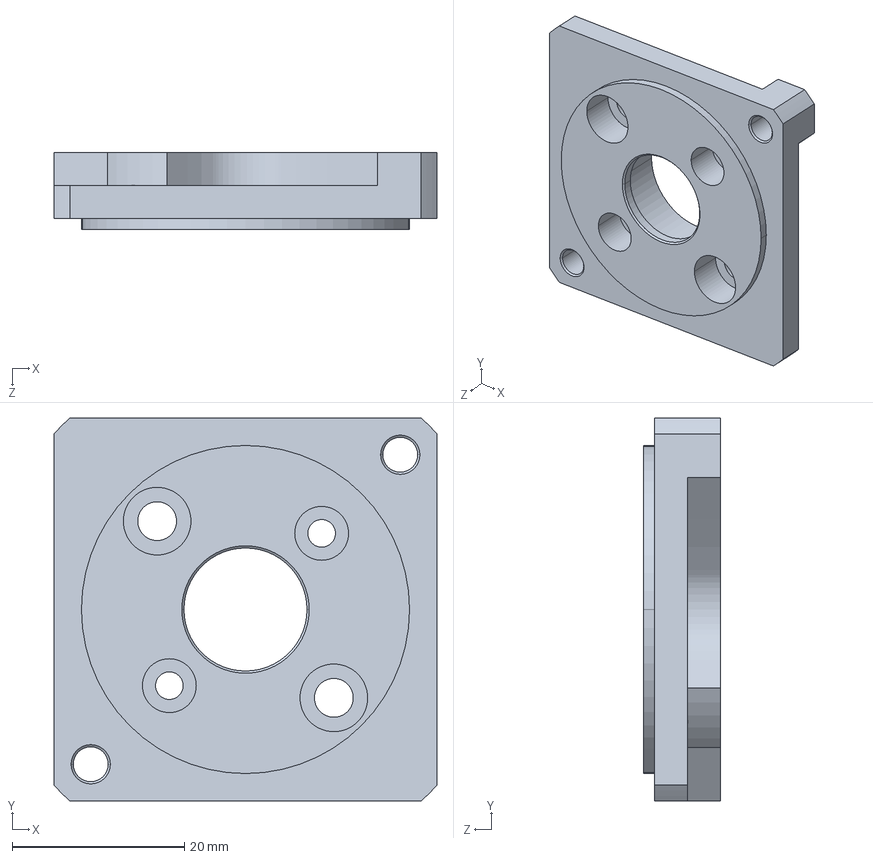
[picture p91: CAD file, 2018-11-10]
Swerve_Drive_CAD/am-3765+-+57+Sport+Motor+Block.STEP
44.5 x 44.5 x 8.89 mm
