BenzeneBots/Swerve_Drive/Swerve_Drive_CAD/BB_Swerve_Saddle_Stock.SLDPRT

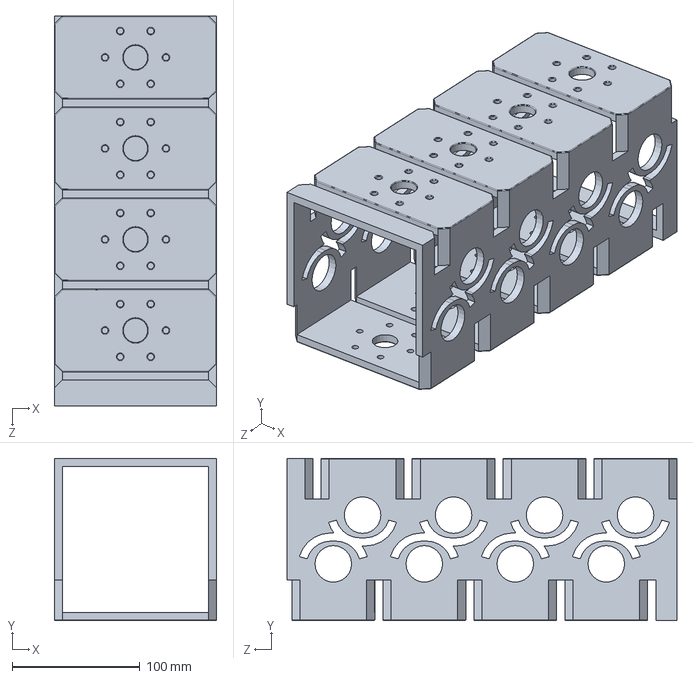
[picture p92: CAD file, 2018-10-16]
Swerve_Drive_CAD/BB_Swerve_Saddle_Stock.SLDPRT
127.0 x 127.0 x 304.8 mm
