BenzeneBots/Swerve_Drive/Swerve_Drive_CAD/_5905K730_STL_NEEDLE-ROLLER_BRNG.sldprt

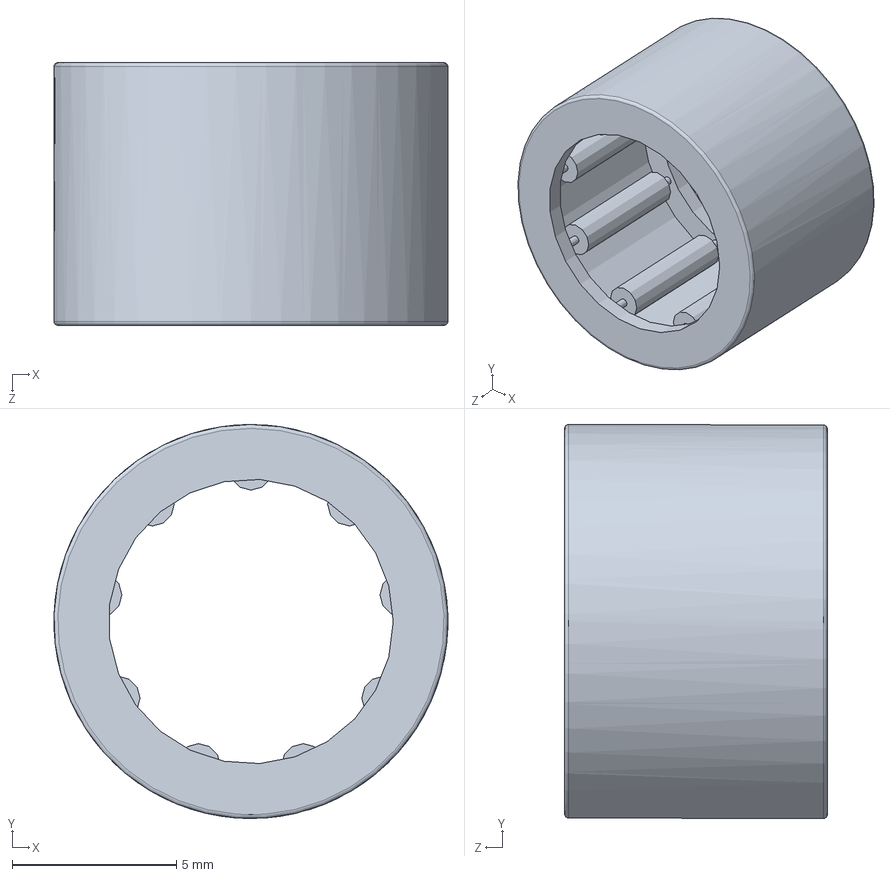
[picture p93: CAD file, 2018-10-12]
Swerve_Drive_CAD/_5905K730_STL_NEEDLE-ROLLER_BRNG.sldprt
12.0 x 12.0 x 8.00 mm
