BenzeneBots/Swerve_Drive/Swerve_Drive_CAD/_98164A211.sldprt

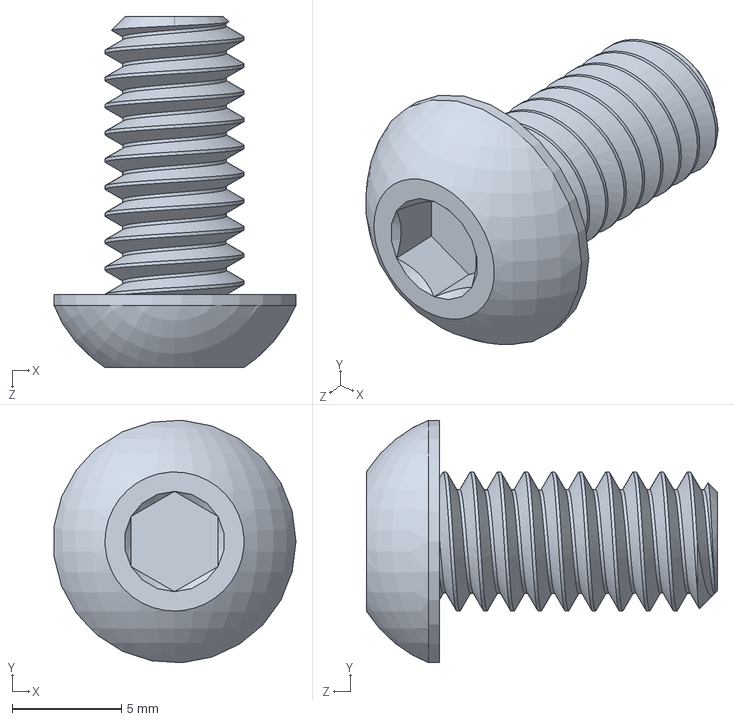
[picture p94: CAD file, 2018-10-12]
Swerve_Drive_CAD/_98164A211.sldprt
11.1 x 11.1 x 16.1 mm
