BenzeneBots/Swerve_Drive/Swerve_Drive_CAD/_38T_HTD_PULLEY_AZ_FLANGE.SLDPRT

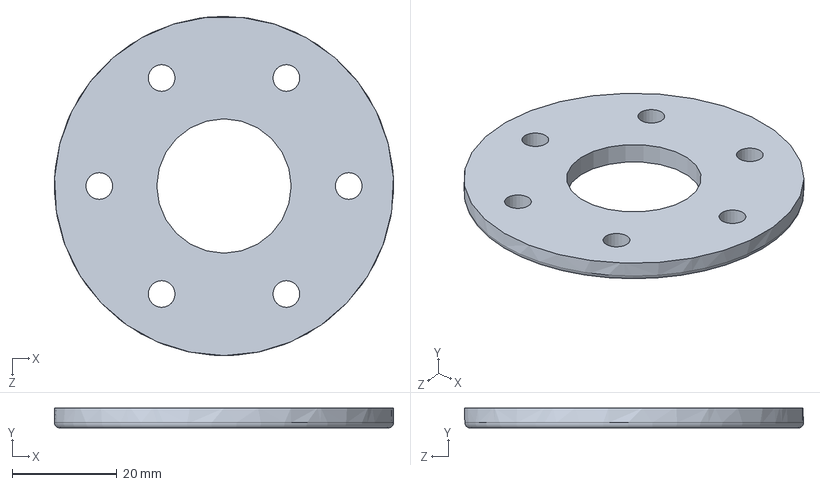
[picture p95: CAD file, 2018-10-12]
Swerve_Drive_CAD/_38T_HTD_PULLEY_AZ_FLANGE.SLDPRT
64.7 x 3.81 x 64.8 mm
