BenzeneBots/Swerve_Drive/Swerve_Drive_CAD/_HTD_TB_PULLEY_38T_SWERVE.SLDPRT

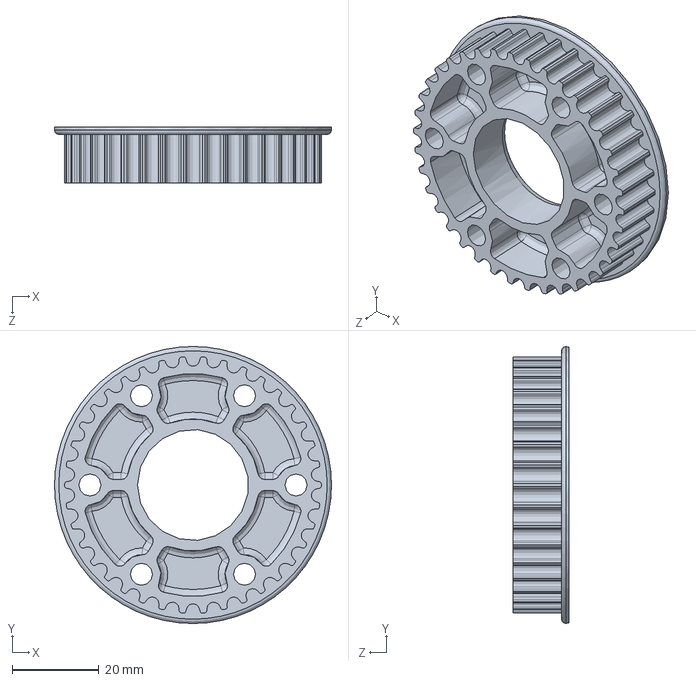
[picture p96: CAD file, 2018-10-12]
Swerve_Drive_CAD/_HTD_TB_PULLEY_38T_SWERVE.SLDPRT
64.0 x 64.0 x 13.0 mm
