BenzeneBots/Swerve_Drive/(list of files, cad)

Other CAD files:
FRC_2767/FRC 2767 2018 CAD/217-2736_20121205_1_ASM.sldasm
FRC_2767/FRC 2767 2018 CAD/8MM_SHAFT_44T_HTD_PULLEY_ASM.sldasm
FRC_2767/FRC 2767 2018 CAD/217-2736_20121205_ASM.sldasm
Swerve_Drive_CAD/VersaPlanetary_Integrated_Encoder_217-5046.SLDASM
Swerve_Drive_CAD/217-2625-100_1.sldasm
Swerve_Drive_CAD/am-XXXX - 57 Sport 500 Hex Output Plug.sldasm
Swerve_Drive_CAD/217-2820 Rev1_Public.sldasm
Swerve_Drive_CAD/217-2818 Rev1.sldasm
Swerve_Drive_CAD/217-2625-100.sldasm
Swerve_Drive_CAD/am-XXXX - 4_1 Input Stage.sldasm
FRC_2767/FRC 2767 2018 CAD/SWERVE_PIVOT_HUB_TUBE.sldprt
FRC_2767/FRC 2767 2018 CAD/HTD_TB_PULLEY_38T_SWERVE.sldprt
Swerve_Drive_CAD/217-4783-004 Rev2_40t_spur_REF_14deg.sldprt
FRC_2767/FRC 2767 2018 CAD/TOPHAT_SLEEVE.sldprt
Swerve_Drive_CAD/217-4783-008 Rev2_1.sldprt
FRC_2767/FRC 2767 2018 CAD/SWERVE_MOUNTING_HUB.sldprt
FRC_2767/FRC 2767 2018 CAD/8MM_VERT_DRIVE_SHAFT.sldprt
FRC_2767/FRC 2767 2018 CAD/217-4046-STEP-20141030.sldprt
FRC_2767/FRC 2767 2018 CAD/2016_SWERVE_AXLE_RNM_RNM.sldprt
Swerve_Drive_CAD/217-4783-005 Rev7_40t_spur_REF_14deg_1.sldprt
FRC_2767/FRC 2767 2018 CAD/AM-2620_40T_1-25MOD_BEVEL_GEAR.sldprt
Swerve_Drive_CAD/Drive_Belt.sldprt
Swerve_Drive_CAD/217-4783-005 Rev7_40t_spur_REF_14deg.sldprt
FRC_2767/FRC 2767 2018 CAD/217-2736-001_REV1-1-SOLID1.sldprt
Swerve_Drive_CAD/217-4783-006 Rev3_1.sldprt
FRC_2767/FRC 2767 2018 CAD/217-4006-STEP-20140807.sldprt
Swerve_Drive_CAD/217-4783-001 Rev3_1.sldprt
FRC_2767/FRC 2767 2018 CAD/COLSON_WHEEL_MODIFIED.sldprt
Swerve_Drive_CAD/217-4783-007 Rev1_1.sldprt
Swerve_Drive_CAD/217-4783-002 Rev7_Sealed Config.sldprt
FRC_2767/FRC 2767 2018 CAD/AM-2621_20T_1-25MOD_BEVEL_GEAR.sldprt
Swerve_Drive_CAD/217-4783-003 Rev4_1.sldprt
FRC_2767/FRC 2767 2018 CAD/44T_HTD_PULLEY_FLANGE.sldprt
Swerve_Drive_CAD/217-2788-001 Rev3_57155K375_1.sldprt
FRC_2767/FRC 2767 2018 CAD/8MM_PULLEY_HUB.sldprt
FRC_2767/FRC 2767 2018 CAD/38T_HTD_PULLEY_AZ_FLANGE.sldprt
FRC_2767/FRC 2767 2018 CAD/HTD_TB_PULLEY_44T.sldprt
Swerve_Drive_CAD/217-2788-001 Rev3_57155K375.sldprt
FRC_2767/FRC 2767 2018 CAD/SWERVE_PIVOT_HUB_MOUNT.sldprt
Swerve_Drive_CAD/217-4783-002 Rev7_Sealed Config_1.sldprt
Swerve_Drive_CAD/217-4783-004 Rev2_40t_spur_REF_14deg_1.sldprt
Swerve_Drive_CAD/PCBA Rev3_1.sldprt
Swerve_Drive_CAD/Output Block.sldprt
Swerve_Drive_CAD/217-4649-002 Rev1_SSA0832-0500ZC.sldprt
Swerve_Drive_CAD/SSA_SSA0832-0500ZC.sldprt
Swerve_Drive_CAD/217-2625-009 Rev1.sldprt
Swerve_Drive_CAD/SSHCM004_SSHCM004070010C.sldprt
Swerve_Drive_CAD/BB_Swerve_Saddle.SLDPRT
Swerve_Drive_CAD/217-2725-001 Rev1_24t Sun.sldprt
Swerve_Drive_CAD/TRUARC-5103-68_97414A675_grv.sldprt
Swerve_Drive_CAD/217-2822-003 Rev4_1.sldprt
Swerve_Drive_CAD/217-2741.sldprt
Swerve_Drive_CAD/217-2625-005 Rev1_Planet_Revolving_Follower01.sldprt
Swerve_Drive_CAD/217-2625-010 Rev1_1.sldprt
Swerve_Drive_CAD/217-2625-025 Rev1.sldprt
Swerve_Drive_CAD/am-XXXX - 57 Sport Shaft Carrier Plate.sldprt
Swerve_Drive_CAD/217-2625-003 Rev1_1.sldprt
Swerve_Drive_CAD/217-2625-017 Rev1_9714K61.sldprt
Swerve_Drive_CAD/retaining Ring 0500 - Mcm 98410A122_98410A122.sldprt
Swerve_Drive_CAD/217-2625-018 Rev1_98541A410.sldprt
Swerve_Drive_CAD/FR8ZZ Bearing.sldprt
Swerve_Drive_CAD/217-4649-007 Rev1_94105A824.sldprt
Swerve_Drive_CAD/SPRGW0856-1102-012_9714K62.sldprt
Swerve_Drive_CAD/217-4649-001 Rev1.sldprt
Swerve_Drive_CAD/217-4649-006 Rev1_SSA0004-008BA.sldprt
Swerve_Drive_CAD/217-3351 Rev2.sldprt
Swerve_Drive_CAD/_AM_0931.SLDPRT
Swerve_Drive_CAD/am-XXXX - 57 Sport 500 Hex Shaft.sldprt
Swerve_Drive_CAD/217-2625-026 Rev1.sldprt
Swerve_Drive_CAD/217-2725-002 Rev1_24t Planet.sldprt
Swerve_Drive_CAD/217-2625-001 Rev1.sldprt
Swerve_Drive_CAD/SSA_SSA0832-1750ZC.sldprt
Swerve_Drive_CAD/217-3351.sldprt
Swerve_Drive_CAD/217-2625-005 Rev1_Planet_Revolving_Follower01_1.sldprt
Swerve_Drive_CAD/217-2625-008 Rev1_1.sldprt
Swerve_Drive_CAD/am-XXXX - 57 Sport 1 Stage Ring Gear Housing.sldprt
Swerve_Drive_CAD/10-32 x 1.750 SHCS_90128A953.sldprt
Swerve_Drive_CAD/TRUARC-MSH-15_98541A410.sldprt
Swerve_Drive_CAD/217-2724-002 Rev1.sldprt
Swerve_Drive_CAD/217-2742-001 Rev4.sldprt
Swerve_Drive_CAD/SSS1032-0125ZB_94105A824.sldprt
Swerve_Drive_CAD/217-2742.sldprt
Swerve_Drive_CAD/217-2816-001 Rev1_1.sldprt
Swerve_Drive_CAD/16T Planet Gear.sldprt
Swerve_Drive_CAD/217-2625-007 Rev1_Public.sldprt
Swerve_Drive_CAD/217-2625-007 Rev1_Sun_Driver01.sldprt
Swerve_Drive_CAD/217-2625-011 Rev1_1.sldprt
Swerve_Drive_CAD/10-32 X 375 SHCS_90128A940.sldprt
Swerve_Drive_CAD/217-2625-002 Rev1.sldprt
FRC_2767/FRC 2767 2018 CAD/5905K730_STL_NEEDLE-ROLLER_BRNG.sldprt
FRC_2767/FRC 2767 2018 CAD/91525A119.sldprt
FRC_2767/FRC 2767 2018 CAD/92185A108-1-SOLID1.sldprt
FRC_2767/FRC 2767 2018 CAD/9657K101_STEEL_COMPRESSION_SPRI.sldprt
FRC_2767/FRC 2767 2018 CAD/98164A211.sldprt
FRC_2767/FRC 2767 2018 CAD/AL_WASHER.sldprt
FRC_2767/FRC 2767 2018 CAD/STEEL_SHIM_WASHER.sldprt
Swerve_Drive_CAD/217-2625-003 Rev1.sldprt
Swerve_Drive_CAD/217-2625-008 Rev1.sldprt
Swerve_Drive_CAD/217-2625-010 Rev1.sldprt
Swerve_Drive_CAD/217-2625-011 Rev1.sldprt
Swerve_Drive_CAD/217-2816-001 Rev1.sldprt
Swerve_Drive_CAD/217-2822-003 Rev4.sldprt
Swerve_Drive_CAD/217-4783-001 Rev3.sldprt
Swerve_Drive_CAD/217-4783-003 Rev4.sldprt
Swerve_Drive_CAD/217-4783-006 Rev3.sldprt
Swerve_Drive_CAD/217-4783-007 Rev1.sldprt
Swerve_Drive_CAD/217-4783-008 Rev2.sldprt
Swerve_Drive_CAD/832-1750-Ring-Gear-Screw_SSA0832-0500ZC.sldprt
Swerve_Drive_CAD/BB_Swerve_Saddle.SLDDRW
Swerve_Drive_CAD/PCBA Rev3.sldprt
Swerve_Drive_CAD/Thrust washer - 775 Sport.sldprt
Swerve_Drive_CAD/_AL_WASHER.SLDPRT
Swerve_Drive_CAD/_STEEL_SHIM_WASHER.SLDPRT
Swerve_Drive_CAD/am-2234_42toothHTDpulleyHalfRev2.SLDPRT
Swerve_Drive_CAD/am-3403+24+tooth+HTD+pulley+half+500hex.SLDPRT
Swerve_Drive_CAD/am-3658+-+4_1+-+57+Sport.SLDASM
Swerve_Drive_CAD/am-3765 - 57 Sport Motor Block.sldprt
Swerve_Drive_CAD/am-3775+RedLine+Motor.SLDPRT
