BenzeneBots/Swerve_Drive/(commit log)

2018-10-11 initial Commit
    Starting Swerve Drive
    [2016_SWERVE_AXLE_RNM_RNM.sldprt, 2018_swerve_module_asm.SLDASM, 217-2736-001_REV1-1-SOLID1.sldprt, 217-2736_20121205_1_ASM.sldasm, 217-2736_20121205_ASM.sldasm, 217-4006-STEP-20140807.sldprt, 217-4046-STEP-20141030.sldprt, 38T_HTD_PULLEY_AZ_FLANGE.sldprt]
2018-10-11 Added Saddle Stock
    Saddle(s) are cut from 5" square tube that has 1/4" walls.
    [2016_SWERVE_AXLE_RNM_RNM.sldprt, 2018_swerve_module_asm.SLDASM, 217-2736-001_REV1-1-SOLID1.sldprt, 217-2736_20121205_1_ASM.sldasm, 217-2736_20121205_ASM.sldasm, 217-4006-STEP-20140807.sldprt, 217-4046-STEP-20141030.sldprt, 38T_HTD_PULLEY_AZ_FLANGE.sldprt]
2018-10-12 Added SolidWorks version of CAD files.
    [2016_SWERVE_AXLE_RNM_RNM.sldprt, 2018_swerve_module_asm.SLDASM, 217-2736-001_REV1-1-SOLID1.sldprt, 217-2736_20121205_1_ASM.sldasm, 217-2736_20121205_ASM.sldasm, 217-4006-STEP-20140807.sldprt, 217-4046-STEP-20141030.sldprt, 38T_HTD_PULLEY_AZ_FLANGE.sldprt]
2018-10-16 Added Part Tool Paths
    [2016_SWERVE_AXLE_RNM_RNM.sldprt, 2018_swerve_module_asm.SLDASM, 217-2736-001_REV1-1-SOLID1.sldprt, 217-2736_20121205_1_ASM.sldasm, 217-2736_20121205_ASM.sldasm, 217-4006-STEP-20140807.sldprt, 217-4046-STEP-20141030.sldprt, 38T_HTD_PULLEY_AZ_FLANGE.sldprt]
2018-11-10 Added frame assembly.
    [10-32 X 375 SHCS_90128A940.sldprt, 10-32 x 1.750 SHCS_90128A953.sldprt, 16T Planet Gear.sldprt, 217-2625-001 Rev1.sldprt, 217-2625-002 Rev1.sldprt, 217-2625-003 Rev1.sldprt, 217-2625-003 Rev1_1.sldprt, 217-2625-005 Rev1_Planet_Revolving_Follower01.sldprt]
2018-11-13 Updated 100:1 Gearbox
    [217-2788-001 Rev3_57155K375.sldprt, 217-2788-001 Rev3_57155K375_1.sldprt, 217-4783-001 Rev3.sldprt, 217-4783-001 Rev3_1.sldprt, 217-4783-002 Rev7_Sealed Config.sldprt, 217-4783-002 Rev7_Sealed Config_1.sldprt, 217-4783-003 Rev4.sldprt, 217-4783-003 Rev4_1.sldprt]
2018-11-18 Current Update
    [BB_Swerve_Assem.SLDASM, Drive_Assem.SLDASM, Pulley_Driver.SLDPRT]
